pyrex8/pico-iie/images/pico-iie_bin_file_download.jpg

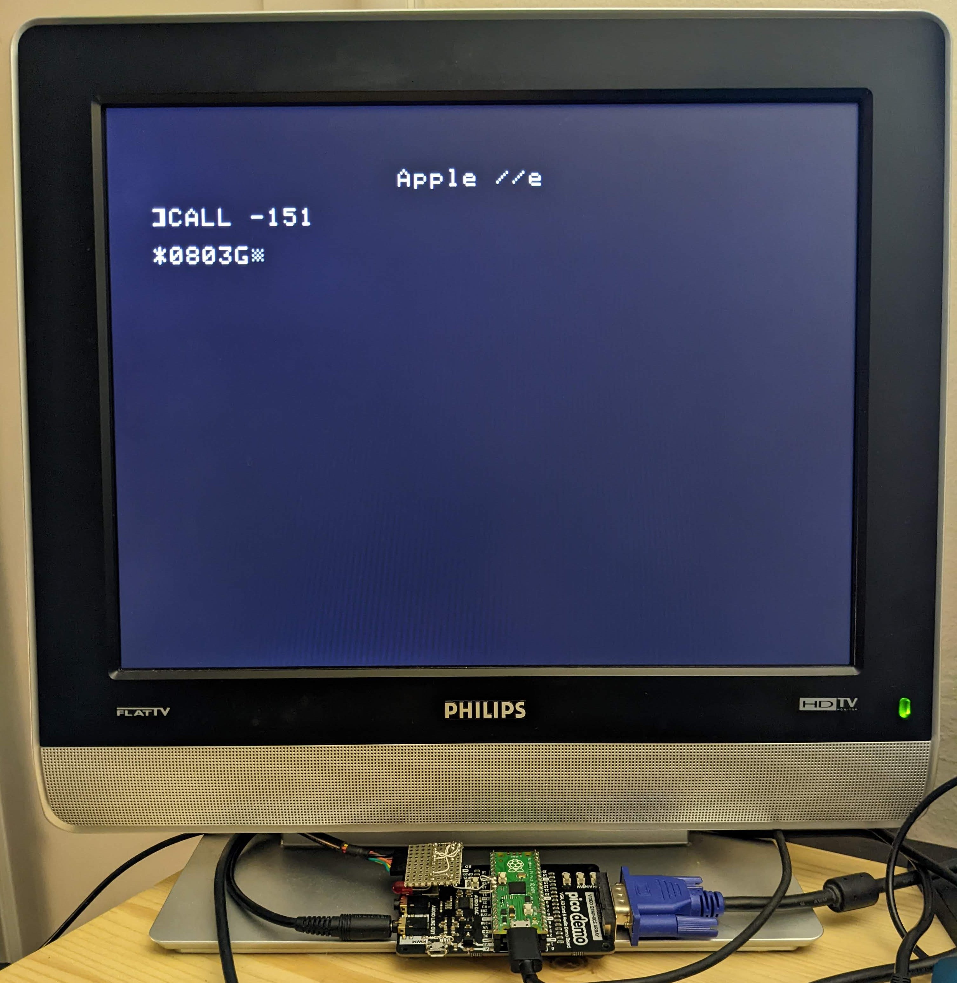
images/pico-iie_bin_file_download.jpg
