pyrex8/pico-iie/images/pico-iie_board1.jpg

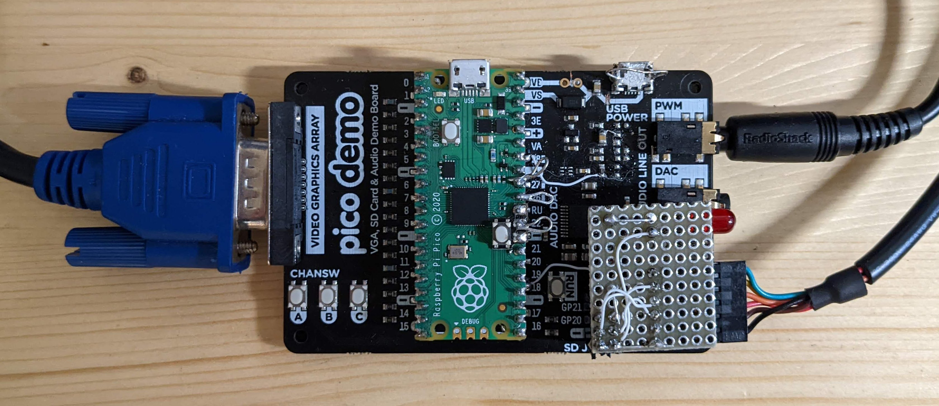
images/pico-iie_board1.jpg
