pyrex8/pico-iie/images/pico-iie_jumpers_bottom.jpg

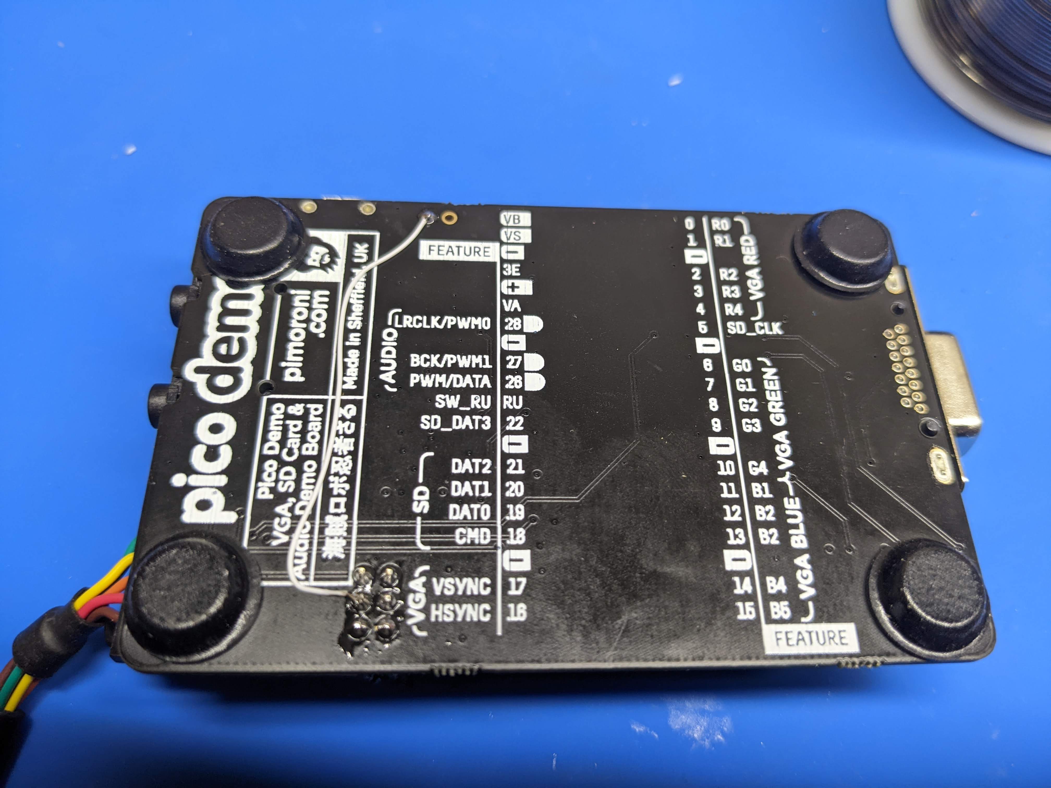
images/pico-iie_jumpers_bottom.jpg
