pyrex8/pico-iie/images/pico-iie_jumpers_top.jpg

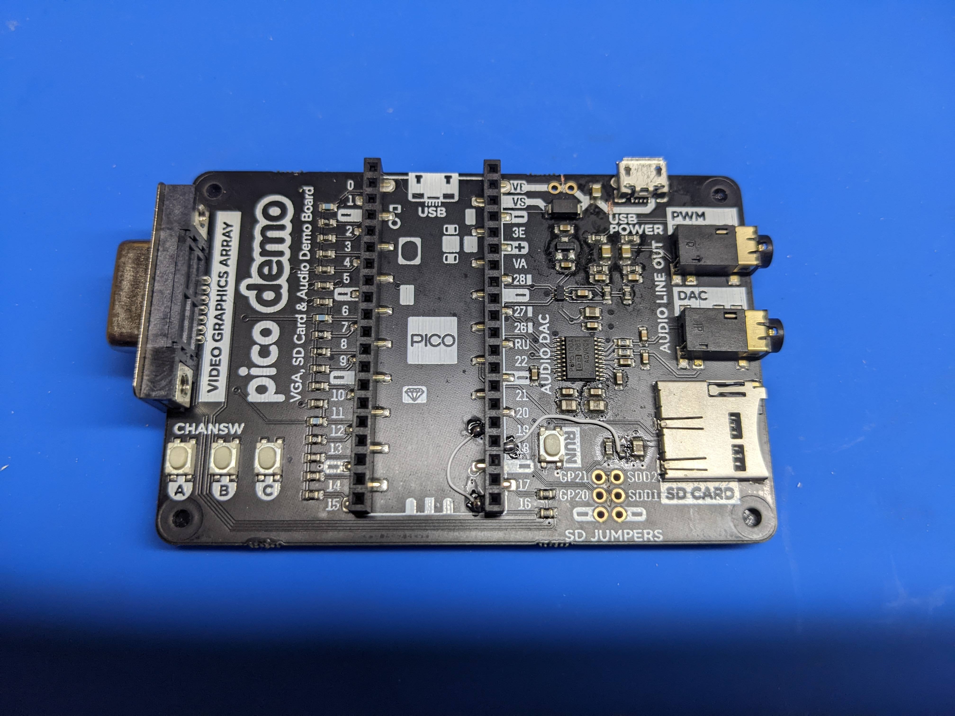
images/pico-iie_jumpers_top.jpg
