pyrex8/pico-iie/(threads)

Thread 1 (2022-09-14):

m6502 @ 3d0d0f1 - Error 404

makertobi, 2022-09-14:
@pyrex8
c6502.c not available. Fatal Error: Remote branch master not found in upstream origin. Can't compile the Pico c/c++-code.
It looks like https://github.com/pyrex8/m6502.git was removed from Github. Please provide it again

pyrex8, 2022-10-29:
I apologize. I had it as a private repo. Please let me know it this fixes the issue.

pyrex8, 2022-10-29:
I somehow missed your original comment. I didn't realize I had left the
repo as private. I hope this fixes the problem.

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

pyrex8, 2022-10-31:
Changed  https://github.com/pyrex8/m6502.git from private to public.

makertobi, 2022-11-01:
Perfect. It worked. Thank You.

Closed 2022-10-31.

Thread 3 (2024-06-19):

can u make it run without mods?

DuckyPolice, 2024-06-19:
can you make a version that doesn't require me destroying my pimorini board? thanks

Thread 4 (2025-05-23):

Error when make.

MichaelChuSC, 2025-05-23:
cmake ..    <---completed without error

make -j4  <- there are errors

The errors reported:
[  2%] Built target slower_boot2
[  5%] Built target slower_boot2_library
[  6%] Built target pico-iie_parallel_pio_h
[  7%] Linking CXX executable pico-iie.elf
/usr/lib/gcc/arm-none-eabi/12.2.1/../../../arm-none-eabi/bin/ld: CMakeFiles/pico-iie.dir/mcu/clock.c.o: in function `clock_init':
/home/scchu/pico/pico-iie/mcu/clock.c:7: undefined reference to `set_sys_clock_khz'
collect2: error: ld returned 1 exit status
make[2]: *** [CMakeFiles/pico-iie.dir/build.make:1320: pico-iie.elf] Error 1
make[1]: *** [CMakeFiles/Makefile2:1788: CMakeFiles/pico-iie.dir/all] Error 2
make: *** [Makefile:91: all] Error 2

Errors from: 1.  verg_set_voltage(VREG_VOLTAGE_1_30);
          2. set_sys_clock_khz(CLK_FREQUENCY_KHZ, true);
 
Is there somethig missed during compile??

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
