pyrex8/pico-iie/(list of files, drawings)

Other design files:
common/pcb/pico-iie.dch
common/pcb/pico-iie.dip
pcb/pico-iie.dch
pcb/pico-iie.dip
