pyrex8/pico-iie/mcu/key.h

// one keyboard scan per screen refresh (60Hz) of 16ms
// 3600 PRO Keyboard decoder emulation
// debounce of 7ms to 13ms (one scan is 16ms)
// roll over lockout - if second key is pressed it is locked out until
// current key is released.
// key held down for 534 to 801 ms before auto repeat (48 scans)
// auto repeat at 15 Hz (every 4 scans)

#ifndef __KEY_H__
#define __KEY_H__

typedef enum
{
    KEY_MAIN_NULL = 0,
    KEY_MAIN_PAUSE,
    KEY_MAIN_RESUME,
    KEY_MAIN_RESET,
    KEY_MAIN_MENU,
    KEY_MAIN_MENU_SELECT,
    KEY_OPERATIONS_TOTAL,
} KeyOperation;

void key_init(void);
void key_scan_start(void);
void key_update(void);
void key_command(KeyOperation *operation, uint8_t *data);
uint8_t key_data_waiting(void);
uint8_t key_data_get(void);

#endif /* __KEY_H__ */
