pyrex8/pico-iie/mcu/test.h

#ifndef __TEST_H__
#define __TEST_H__

#include <stdint.h>

// Configuration
#define TEST_PIN_NUMBER 5

void test_pin_init(void);
void test_pin_low(void);
void test_pin_high(void);

#endif /* __TEST_H__ */
