pyrex8/pico-iie/(commit log)

2022-02-06 added one PWM and a PIO pin out on LED
2022-02-09 first signs that DMA is working
2022-02-13 moved pclk and added second test pin
2022-02-14 red led for disk activity
2022-02-14 add UART
2022-02-15 timing of CPU and attached peripherals too slow, 1.64us per cycle
    [main.c]
2022-02-15 420MHz overclock, requires mod to pico.h
2022-02-21 still trying to get DMA ring setting to work
2022-02-22 attempt to chain 2 DMAs
2022-02-22 dual DMA
2022-02-27 changing IRS to time critical section reduced glitching
    [main.c]
2022-02-28 replace loop with memcpy
    [main.c]
2022-03-01 use proper command to trigger DMA
2022-03-01 SOLVED ITgit add .git add .git add .
    [main.c]
2022-03-02 putting disk track nib functionality in
2022-03-02 red disk LED enabled
2022-03-05 change back reset vector for disk reboot
    [main.c, main.py]
2022-03-06 clean up LED logic
2022-03-10 uart functionality all moved to serial module
2022-03-26 added test pin access from 0xCF00 location
2022-03-27 made test pin reflect a real implementation using a flip flop
    [main.c, test.c, test.h]
2022-03-28 added cassette output pin for testing code timing
2022-04-24 adding demo board modifications and schematics
    [pico-iie.dch]
2022-04-27 added perf board schematics
2022-04-29 update LED_GREEN pin to GP16
2022-04-29 rename UART pins
2022-05-01 change LED resistors from 1k to 75 Ohms
    [pico-iie.dch]
2022-05-01 added pcb layout
    [pico-iie.dip]
2022-05-02 update pcb
    [pico-iie.dip]
2022-05-03 add like to pcb case
2022-05-03 OSH park PCB shared
2022-05-17 resizing images and adding bill of materials
2022-05-30 F9 reboot emulator, F10 for exit main.py
    [main.c, main.h, main.py, serial.c, serial.h]
2022-08-28 a few more updates to improve emulation speed
    [pico-iie.dch, pico-iie.dip]
2022-08-28 pcb files accidently moved, put back
    [pico-iie.dch, pico-iie.dip]
2022-11-14 support 1 button joysticks
2022-12-04 remove cassette.c/.h test pin
2022-12-08 remove LEDs from project
2022-12-09 joystick implemented through DB9 connector
2022-12-13 add ps/2 keyboard commands for pause and reset
    [main.c]
2023-02-20 digital joystick implementation and keyboard fix
    [joystick.c]
2023-02-22 bluetooth download and correct joystick orientation
    [joystick.c, main.py, serial.c, serial.h]
2023-03-12 replace keys with key to claen up naming
    [key.c, key.h, keys.c, main.c]
2023-03-17 print test value to text screen memory
2023-09-13 two button joystick support
2023-10-07 PS/2 keyboard needs pull up resistors
2023-10-07 fix joystick and F2 = RESUME
    [joystick.c, main.c]
2023-10-07 add F10 = reboot
    [main.c]
2023-10-08 joystick pull down resistor calculations
2023-10-13 add second set of joystick buttons that use pull down switches
2023-10-23 replace union with just a struct
    [menu.c]
2023-11-19 pico-iie_revd pinout change
2023-12-21 added reset key function
    [key.c, key.h, main.c]
2024-01-06 correct CapsLock key sensing
    [key.c]
2024-01-10 fix lost semicolon that gives compile error
    [key.c]
2024-01-10 fix for allowing consecutive keypress of same key
    [key.c]
